alanpreed/pico-joystick/README.md

# pico-joystick
A USB adapter for analogue Gameport joysticks
