alanpreed/pico-joystick/hardware/output/lid.stl

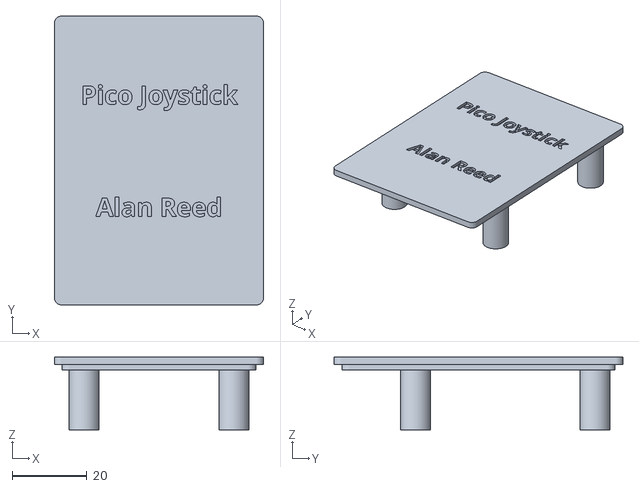
[picture p1: CAD file, 2023-05-13]
hardware/output/lid.stl
56.0 x 77.3 x 19.5
