alanpreed/pico-joystick/hardware/output/case.stl

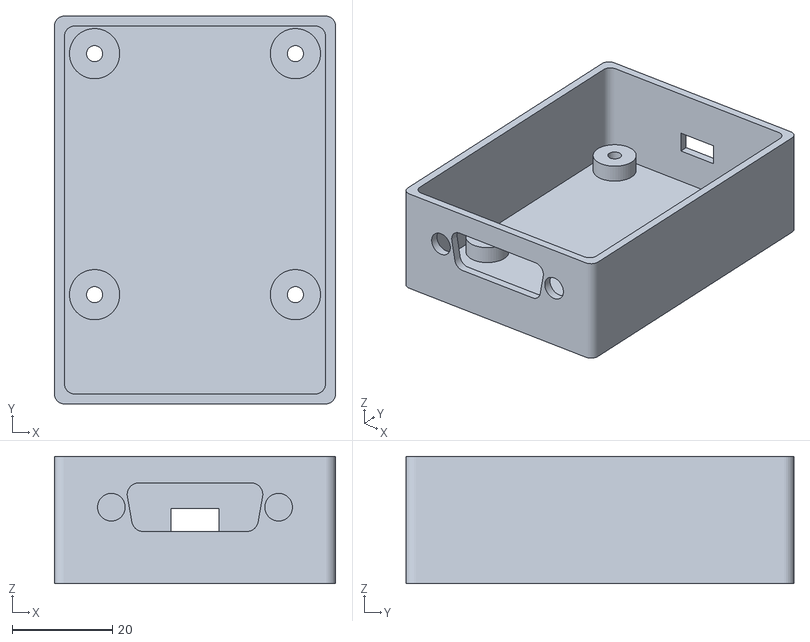
[picture p2: CAD file, 2023-05-13]
hardware/output/case.stl
56.0 x 77.3 x 25.3
