alanpreed/pico-joystick/electronics/output/pico-joystick.pdf

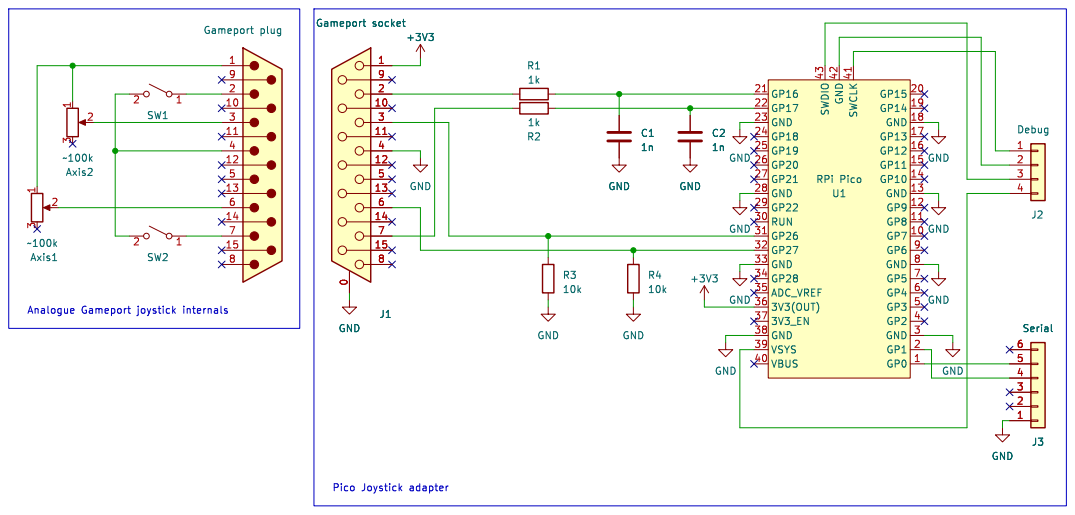
[picture p3: page 1]

Id: 1/1 Title: Pico Joystick schematic
