alanpreed/pico-joystick/electronics/output/pico-joystick schematic v1.pdf

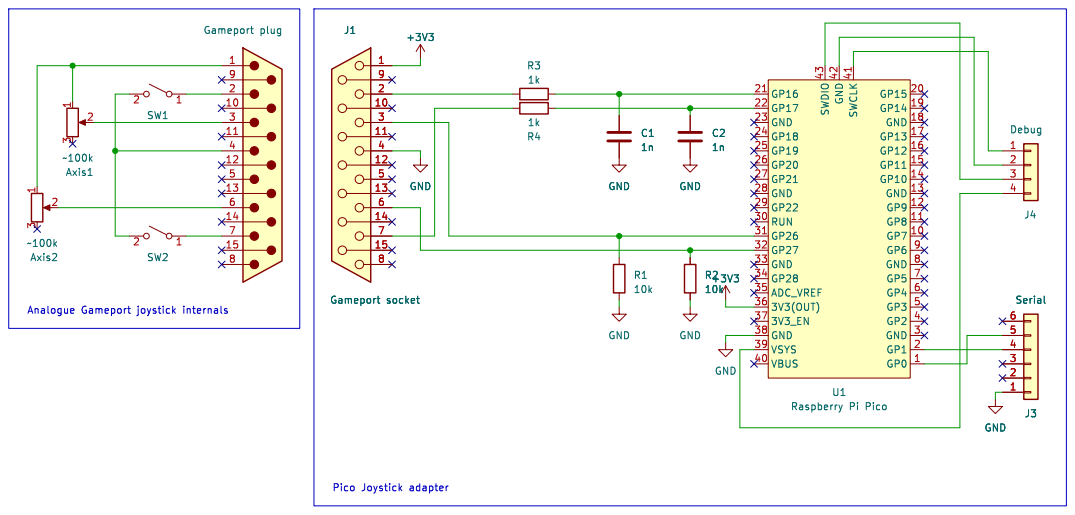
[picture p4: page 1]

Id: 1/1 Title: Pico Joystick schematic
