alanpreed/pico-joystick/electronics/pico-joystick.kicad_pcb

## KiCad design electronics/pico-joystick.kicad_pcb (2023-05-02)

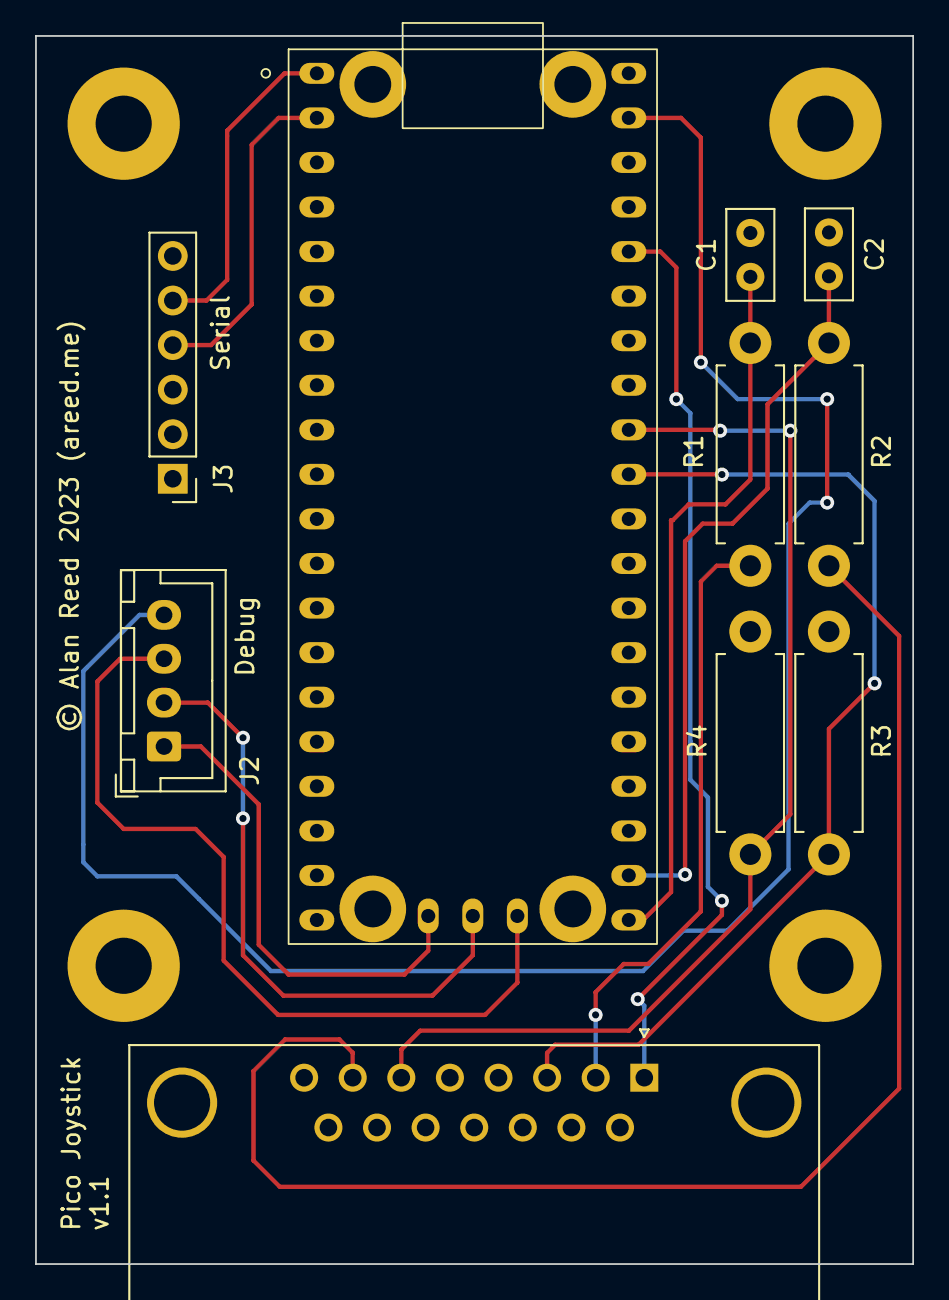
[picture p5: board pico-joystick.kicad_pcb from above]

Board: 2 copper layers, 50.0 x 70.0 mm, 10 parts (0 on the bottom side), 14 nets.

Parts:
C1, C2: 1n; C_Disc_D5.0mm_W2.5mm_P2.50mm
J1: Gameport socket; DSUB-15_Female_Horizontal_P2.77x2.84mm_EdgePinOffset9.90mm_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
J2: Debug; JST_XH_B4B-XH-A_1x04_P2.50mm_Vertical
J3: Serial; PinHeader_1x06_P2.54mm_Vertical
R1, R2: 1k; R_Axial_DIN0411_L9.9mm_D3.6mm_P12.70mm_Horizontal
R3, R4: 10k; R_Axial_DIN0411_L9.9mm_D3.6mm_P12.70mm_Horizontal
U1: Raspberry Pi Pico; Pi_Pico

Connections:
+3V3: J1.1, U1.36 (3V3(OUT))
GND: C1.2, C2.2, J1.0 (PAD), J1.4, J3.1, R3.2, R4.2, U1.3 (GND), U1.8 (GND), U1.13 (GND), U1.18 (GND), U1.23 (GND), U1.28 (GND), U1.33 (GND), U1.38 (GND)
unnamed: J1.2, R1.1
unnamed: J1.7, R2.1
unnamed: J2.1, U1.41 (SWCLK)
unnamed: J2.2, U1.42 (GND)
unnamed: J2.3, U1.43 (SWDIO)
unnamed: J2.4, U1.39 (VSYS)
unnamed: J3.4, U1.2 (GP1)
unnamed: J3.5, U1.1 (GP0)
unnamed: C1.1, R1.2, U1.21 (GP16)
unnamed: C2.1, R2.2, U1.22 (GP17)
unnamed: J1.3, R3.1, U1.31 (GP26)
unnamed: J1.6, R4.1, U1.32 (GP27)
