alanpreed/pico-joystick/(commit log)

2023-04-10 Added initial PCB design
    [pico-joystick-B_Cu.gbr, pico-joystick-B_Mask.gbr, pico-joystick-B_Paste.gbr, pico-joystick-B_Silkscreen.gbr, pico-joystick-Edge_Cuts.gbr, pico-joystick-F_Cu.gbr, pico-joystick-F_Mask.gbr, pico-joystick-F_Paste.gbr]
2023-04-15 Created initial model of the Pico Joystick PCB
    [board.scad, case.scad, dsub.scad, pi_pico.scad]
2023-04-15 Created initial casework design
    [board.scad, case.scad, utilities.scad]
2023-05-02 Corrected PCB design
    [pico-joystick-B_Cu.gbr, pico-joystick-B_Mask.gbr, pico-joystick-B_Paste.gbr, pico-joystick-B_Silkscreen.gbr, pico-joystick-Edge_Cuts.gbr, pico-joystick-F_Cu.gbr, pico-joystick-F_Mask.gbr, pico-joystick-F_Paste.gbr]
2023-05-13 Fixed overlapping text
    [pico-joystick.kicad_sch]
2023-05-13 Corrected casework, generated print models
    [case.scad, case.stl, dsub.scad, lid.stl]
