alanpreed/pico-joystick/(notices)

Notices in the files:
electronics/pico-joystick.kicad_pcb:
© Alan Reed 2023 (areed.me)
